JoeEarlam/LMNC-drone-oscillator/README.md

# LMNC-drone-oscillator

My own take on Look Mum No Computer's reverse avalanche oscillator, as featured in his 100 oscillator drone video. Four oscillators in a eurorack format, with a buffered output.
