JoeEarlam/LMNC-drone-oscillator/front panel.dxf

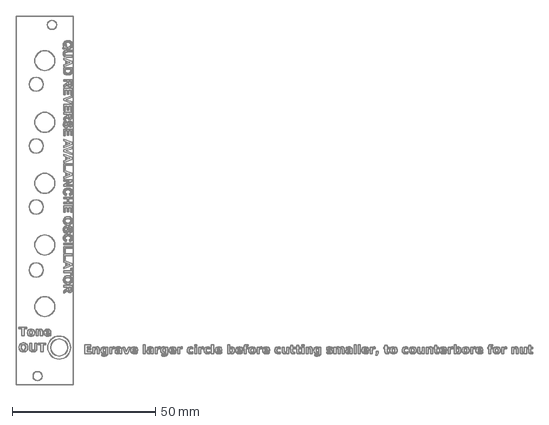
[picture p1: CAD file, 2019-02-18]
front panel.dxf
180.1 x 128.5 mm
