JoeEarlam/LMNC-drone-oscillator/droneoscillator.kicad_pcb

## KiCad design droneoscillator.kicad_pcb (2019-02-18)

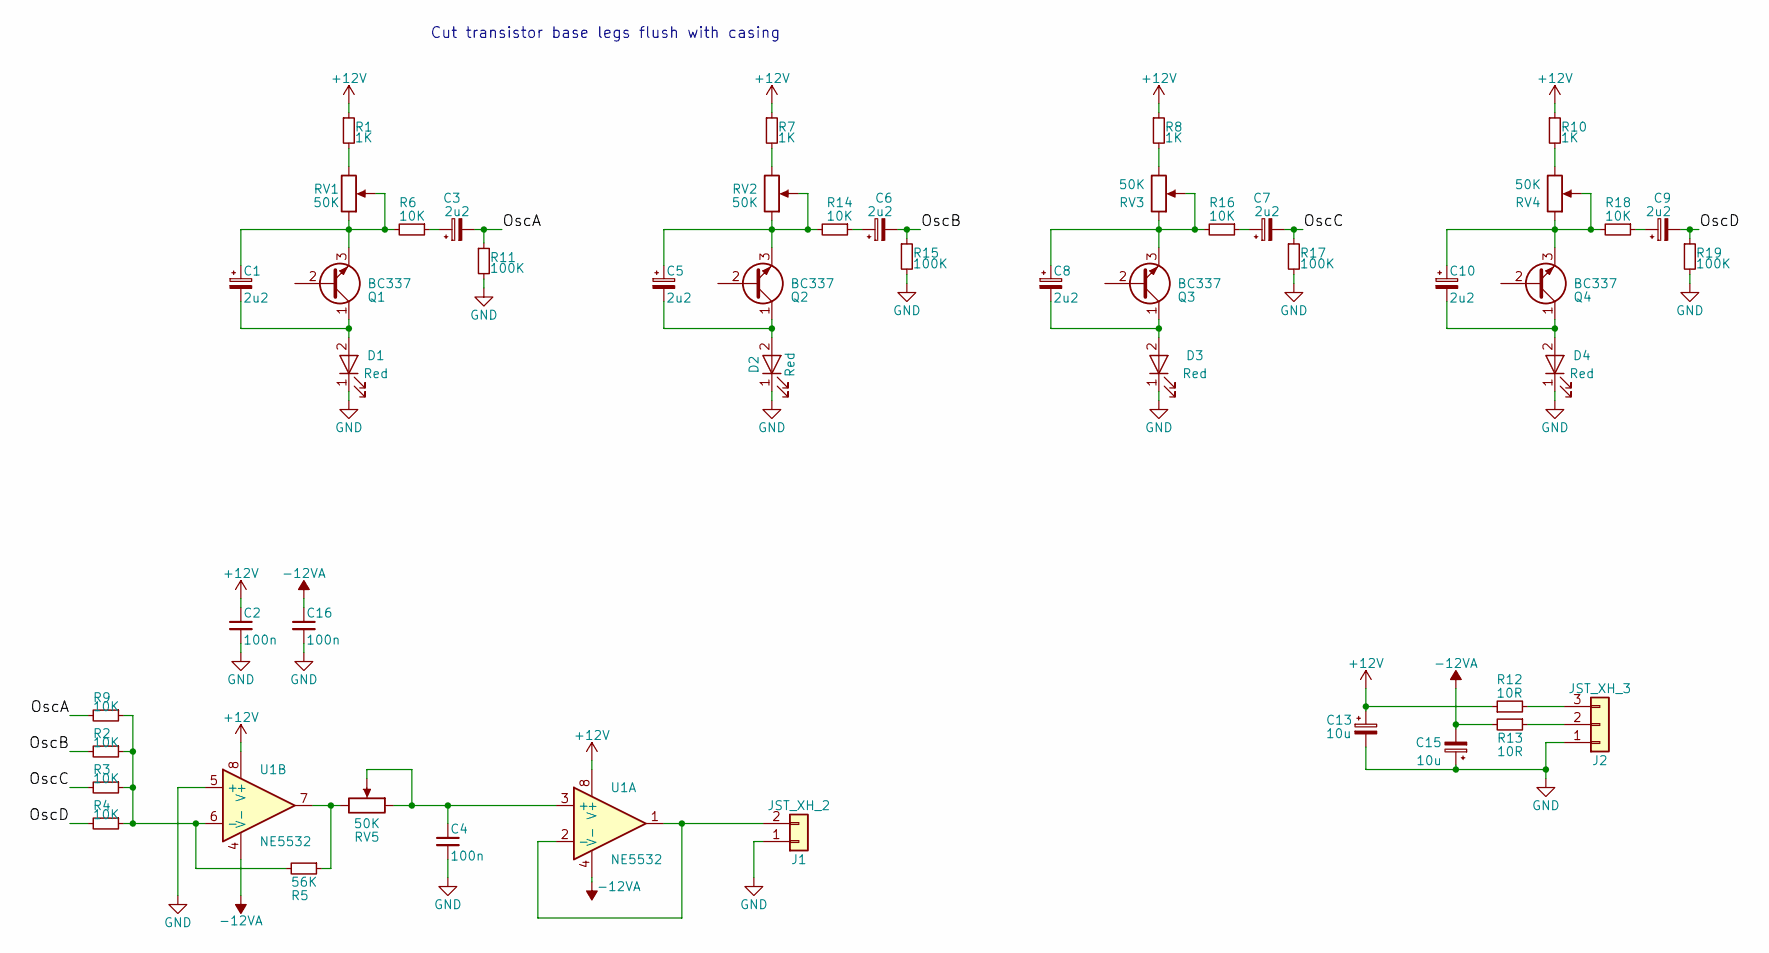
[picture p2: schematic droneoscillator.sch]

Parts:
C1, C3, C5, C6, C7, C8, C9, C10: 2u2; CP_Radial_D4.0mm_P2.00mm
C2, C4, C16: 100n; C_Disc_D4.3mm_W1.9mm_P5.00mm
C13, C15: 10u; CP_Radial_D4.0mm_P2.00mm
D1, D2, D3, D4: Red; LED_D5.0mm_Horizontal_O1.27mm_Z3.0mm
J1: JST_XH_2; JST_XH_B02B-XH-A_1x02_P2.50mm_Vertical
J2: JST_XH_3; JST_XH_B03B-XH-A_1x03_P2.50mm_Vertical
Q1, Q2, Q3, Q4: BC337; TO-92_Inline_Wide
R1, R7, R8, R10: 1K; R_Axial_DIN0204_L3.6mm_D1.6mm_P7.62mm_Horizontal
R2, R3, R4, R6, R9, R14, R16, R18: 10K; R_Axial_DIN0204_L3.6mm_D1.6mm_P7.62mm_Horizontal
R5: 56K; R_Axial_DIN0204_L3.6mm_D1.6mm_P7.62mm_Horizontal
R11, R15, R17, R19: 100K; R_Axial_DIN0204_L3.6mm_D1.6mm_P7.62mm_Horizontal
R12, R13: 10R; R_Axial_DIN0204_L3.6mm_D1.6mm_P7.62mm_Horizontal
RV1, RV2, RV3, RV4, RV5: 50K; Potentiometer_Alps_RK097_Single_Horizontal
U1: NE5532; DIP-8_W7.62mm_Socket_LongPads

Connections:
+12V: C2.1, C13.1, R1.1, R7.1, R8.1, R10.1, R12.1, U1.8 (V+)
-12VA: C15.2, C16.1, R13.2, U1.4 (V-)
/OscA: C3.2, R9.2, R11.1
/OscB: C6.2, R2.2, R15.1
/OscC: C7.2, R3.2, R17.1
/OscD: C9.2, R4.2, R19.1
GND: C2.2, C4.2, C13.2, C15.1, C16.2, D1.1 (K), D2.1 (K), D3.1 (K), D4.1 (K), J1.1, J2.1, R11.2, R15.2, R17.2, R19.2, U1.5 (+)
unnamed: C1.1, Q1.3 (E), R6.2, RV1.1, RV1.2
unnamed: C1.2, D1.2 (A), Q1.1 (C)
unnamed: C3.1, R6.1
unnamed: C4.1, RV5.1, RV5.2, U1.3 (+)
unnamed: C5.1, Q2.3 (E), R14.2, RV2.1, RV2.2
unnamed: C5.2, D2.2 (A), Q2.1 (C)
unnamed: C6.1, R14.1
unnamed: C7.1, R16.1
unnamed: C8.1, Q3.3 (E), R16.2, RV3.1, RV3.2
unnamed: C8.2, D3.2 (A), Q3.1 (C)
unnamed: C9.1, R18.1
unnamed: C10.1, Q4.3 (E), R18.2, RV4.1, RV4.2
unnamed: C10.2, D4.2 (A), Q4.1 (C)
unnamed: J1.2, U1.1, U1.2 (-)
unnamed: J2.2, R13.1
unnamed: J2.3, R12.2
unnamed: R1.2, RV1.3
unnamed: R2.1, R3.1, R4.1, R5.2, R9.1, U1.6 (-)
unnamed: R5.1, RV5.3, U1.7
unnamed: R7.2, RV2.3
unnamed: R8.2, RV3.3
unnamed: R10.2, RV4.3

Notes on the sheet:
Cut transistor base legs flush with casing

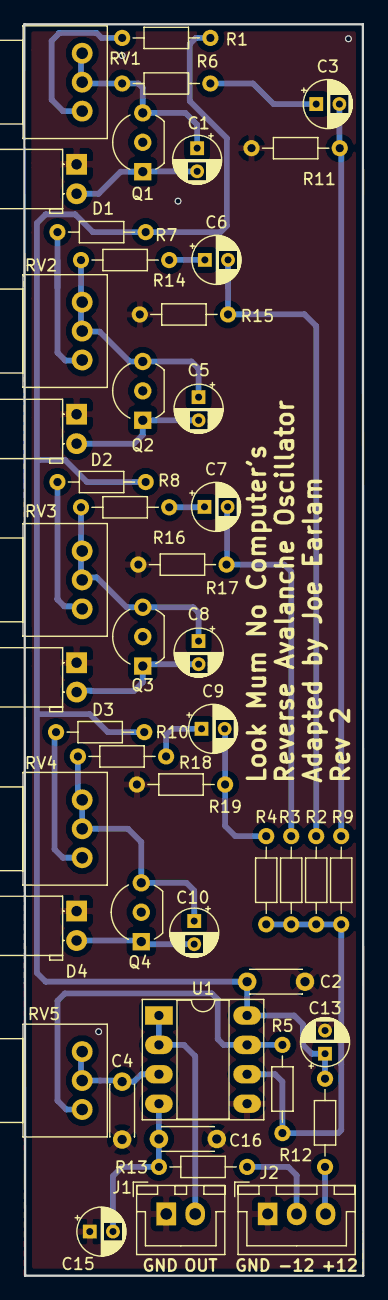
[picture p3: board droneoscillator.kicad_pcb from above]

Board: 2 copper layers, 29.3 x 108.1 mm, 48 parts (0 on the bottom side), 29 nets.
