JoeEarlam/LMNC-drone-oscillator/(commit log)

2018-11-15 Fixed typo in readme, added pdf schematic
2019-01-04 Bug fixes after first prototype build
    [droneoscillator.sch]
2019-01-07 update after prototype build, new PCB layout
    [droneoscillator.kicad_pcb, droneoscillator.sch]
2019-01-07 schematic bugfix, minor changes to PCB
    [_saved_droneoscillator.sch, droneoscillator.kicad_pcb, droneoscillator.sch]
2019-01-07 silkscreen bugfix
    [_saved_droneoscillator.sch, droneoscillator.kicad_pcb, droneoscillator.sch]
2019-01-08 cleaned up cruft
    [droneoscillator-2018-10-20-15-02-09.sch, droneoscillator-2018-11-15-19-08-44.sch]
2019-01-09 change lowest oscillation frequency to 20Hz, fix low output fromixer, minor PCB fixes
2019-01-10 added front panel, adjusted PCB slightly to improve front panel real estate
    [droneoscillator.kicad_pcb, front panel.dxf]
2019-01-16 update front panel
    [front panel.dxf]
2019-01-21 Minor schematic changes after prototype build, cleaned up PCB design
    [_saved_droneoscillator.sch, droneoscillator.kicad_pcb]
2019-01-31 added input filtering to power supply
    [droneoscillator.kicad_pcb, droneoscillator.sch]
2019-01-31 pcb and schematic tweaks
    [droneoscillator.kicad_pcb, droneoscillator.sch]
2019-02-01 changed PCB dimensions to fit wider range of racks
    [droneoscillator.kicad_pcb]
2019-02-02 small tweaks, ready for sending to production
    [droneoscillator.kicad_pcb, droneoscillator.sch, front panel.dxf]
2019-02-02 updated front panel hole dimensions
    [droneoscillator.kicad_pcb, front panel.dxf]
2019-02-07 tag for release to production
    [droneoscillator.kicad_pcb]
2019-02-10 as sent to production
    [droneoscillator.kicad_pcb]
2019-02-18 front panel changes
    [droneoscillator.kicad_pcb, front panel.dxf]
